peedrooh/seebum_sobrado_pcb/line_sensor/datasheets/6-1.png

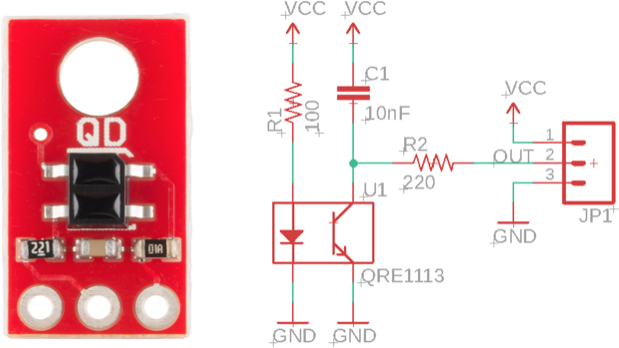
line_sensor/datasheets/6-1.png
