peedrooh/seebum_sobrado_pcb/seebum_esp32s3/Resources/Aliexpress ESP32S3.png

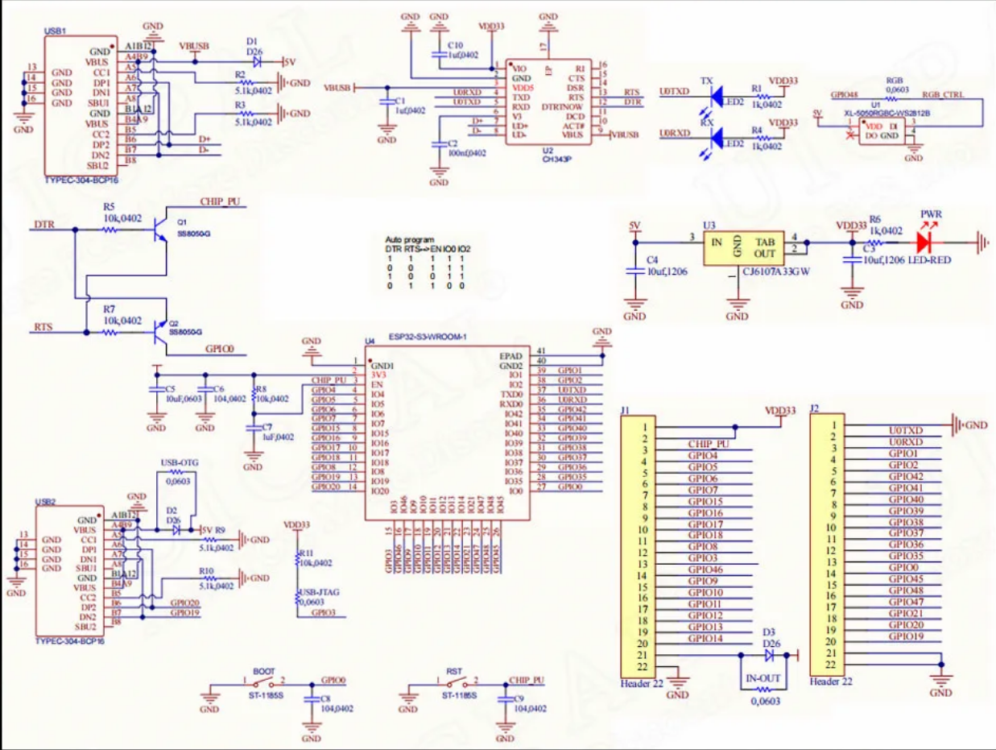
seebum_esp32s3/Resources/Aliexpress ESP32S3.png
