peedrooh/seebum_sobrado_pcb/seebum_esp32s3/Resources/Buck Schematic.png

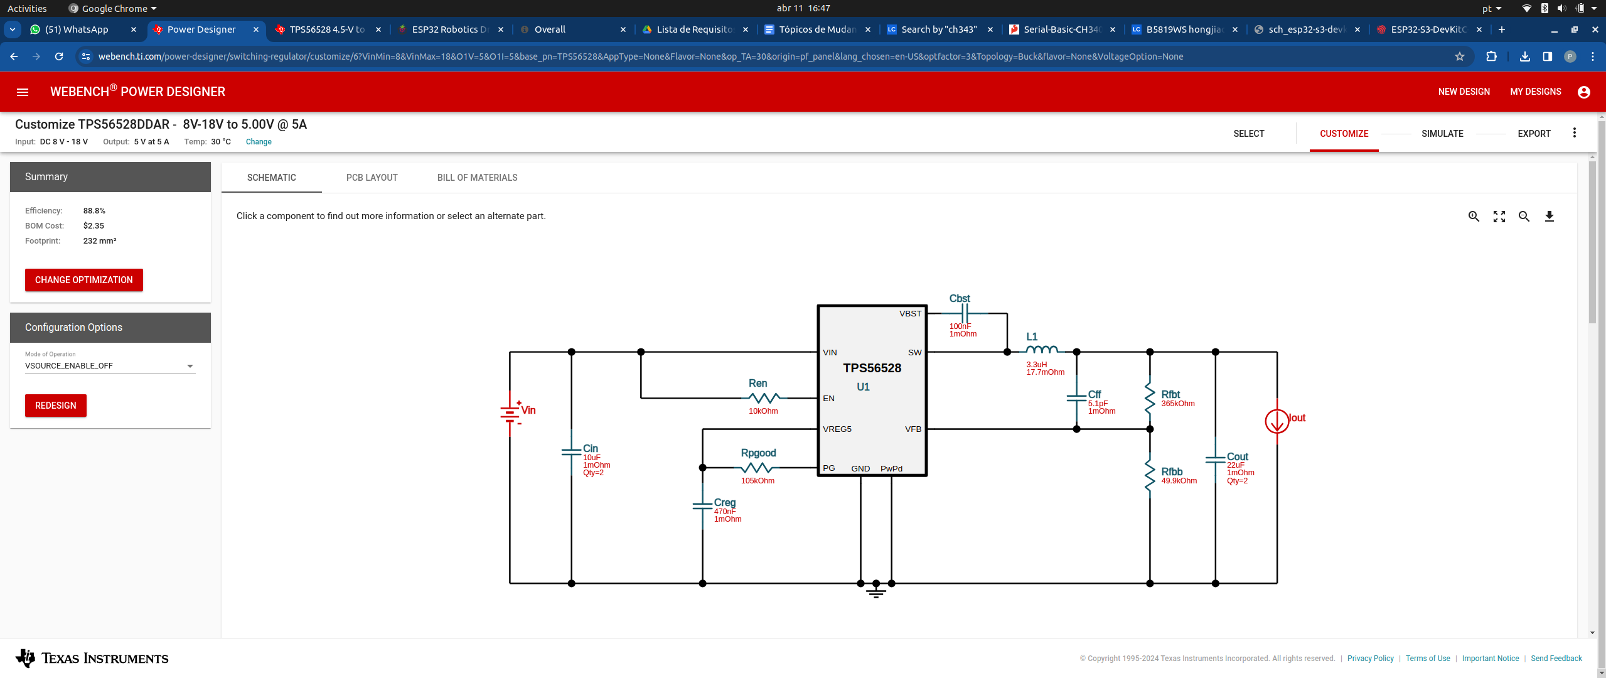
seebum_esp32s3/Resources/Buck Schematic.png
