peedrooh/seebum_sobrado_pcb/seebum_esp32s3/3D Models/User Library-XT30.STEP

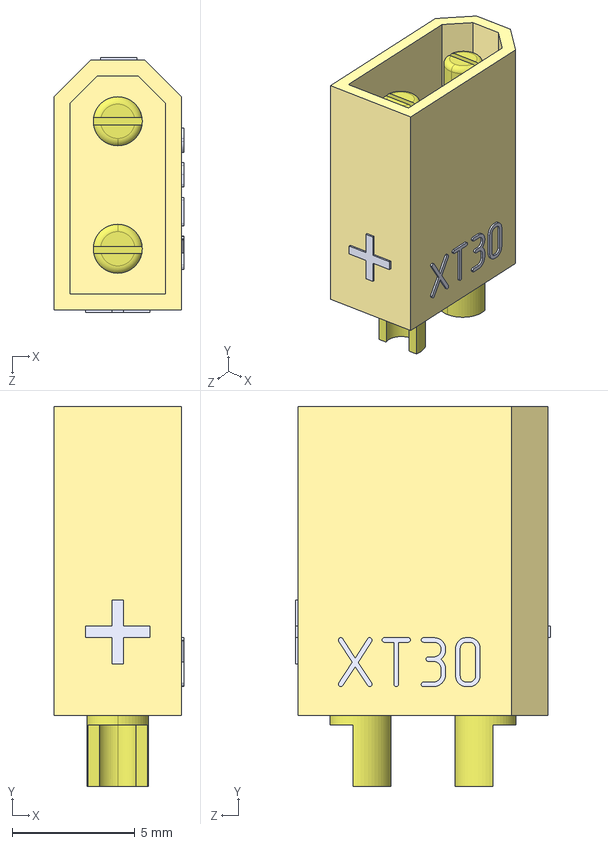
[picture p5: CAD file, 2024-04-22]
seebum_esp32s3/3D Models/User Library-XT30.STEP
5.30 x 15.5 x 10.4 mm
