peedrooh/seebum_sobrado_pcb/seebum_esp32s3/3D Models/xt30-male-2.snapshot.1/XT30-male.stp

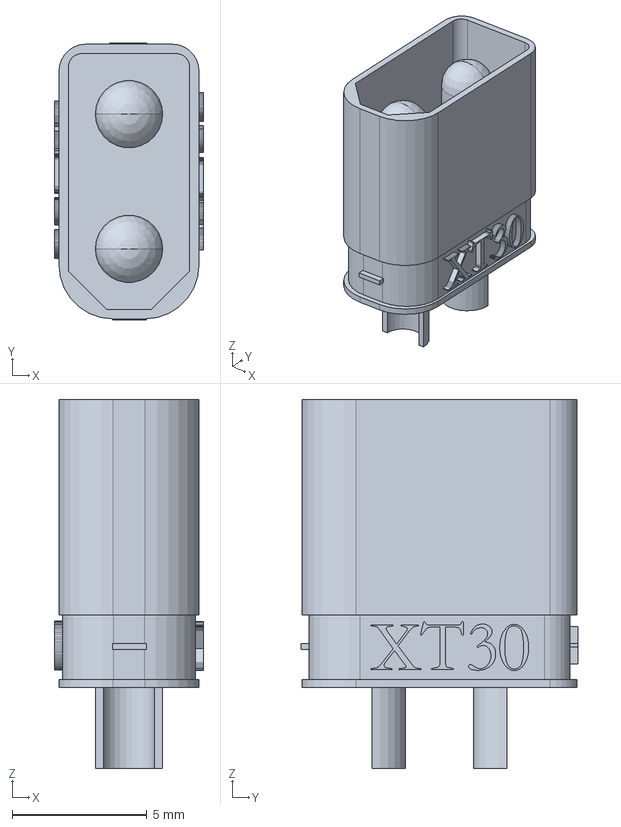
[picture p6: CAD file, 2024-04-22]
seebum_esp32s3/3D Models/xt30-male-2.snapshot.1/XT30-male.stp
5.54 x 10.3 x 13.7 mm
