peedrooh/seebum_sobrado_pcb/Solidworks 3D Models/seebum_peripherals.step

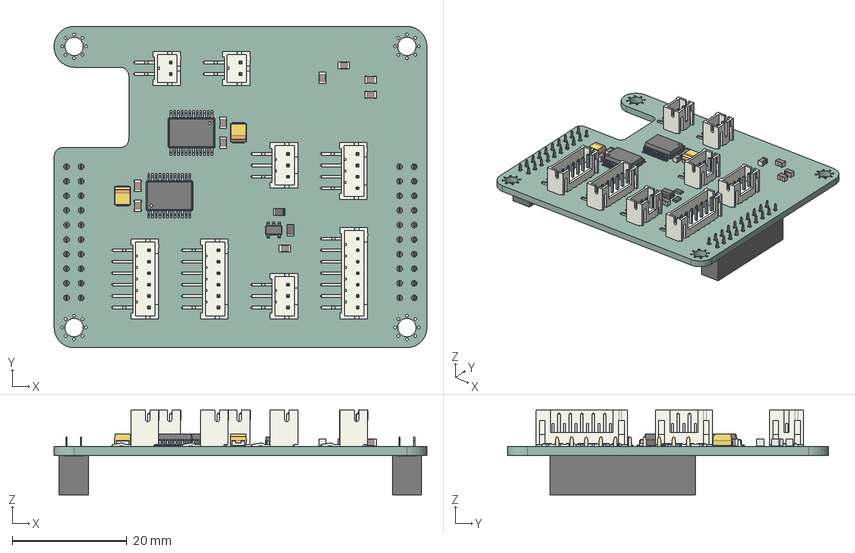
[picture p7: CAD file, 2024-04-23]
Solidworks 3D Models/seebum_peripherals.step
65.0 x 56.0 x 14.8 mm
JST_S4B_PH_K
C_0805_2012Metric x 9
CP_EIA_3528_21_Kemet_B x 2
PinSocket_2x10_P254mm_Vertical x 2
SOT_23_5
JST_S2B_PH_K x 2
JST_S3B_PH_K x 2
SSOP_24_53x82mm_P065mm x 2
JST_S6B_PH_K x 2
R_0805_2012Metric x 2
JST_S7B_PH_K
seebum_peripherals_PCB
