peedrooh/seebum_sobrado_pcb/seebum_esp32s3/3D Models/5Amp_Switch.stp

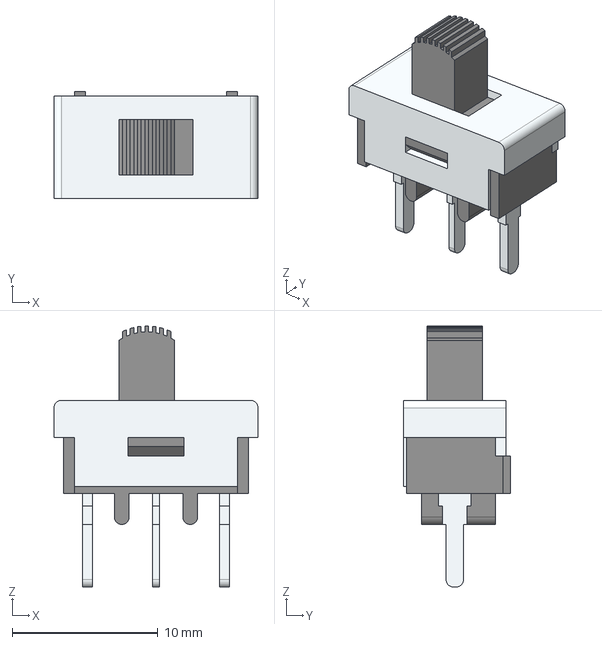
[picture p8: CAD file, 2024-04-22]
seebum_esp32s3/3D Models/5Amp_Switch.stp
14.0 x 7.32 x 17.9 mm
