peedrooh/seebum_sobrado_pcb/seebum_esp32s3/3D Models/Connectors_Amass.3dshapes-master/Amass_MR30PB-FB.step

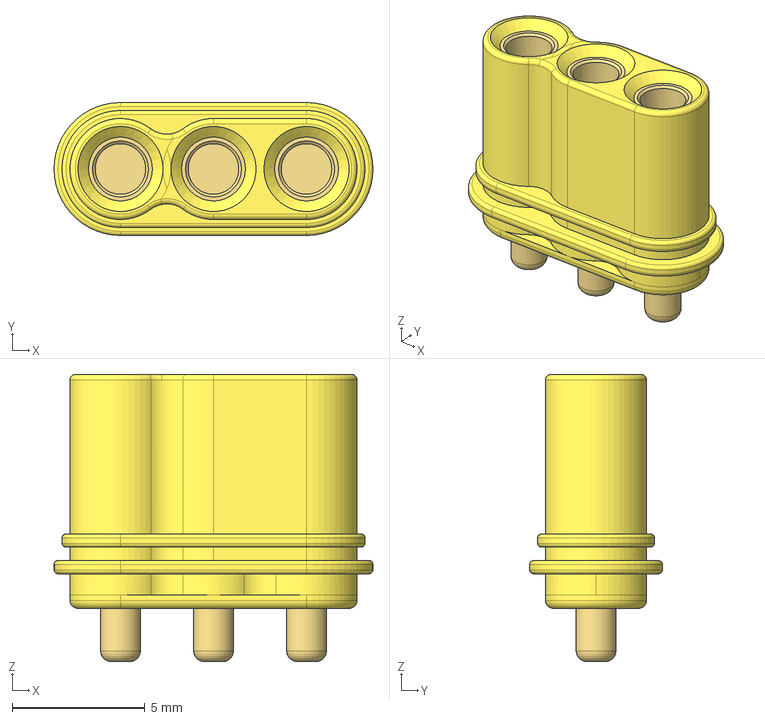
[picture p9: CAD file, 2024-04-22]
seebum_esp32s3/3D Models/Connectors_Amass.3dshapes-master/Amass_MR30PB-FB.step
12.0 x 5.00 x 10.8 mm
