peedrooh/seebum_sobrado_pcb/Solidworks 3D Models/line_sensor.step

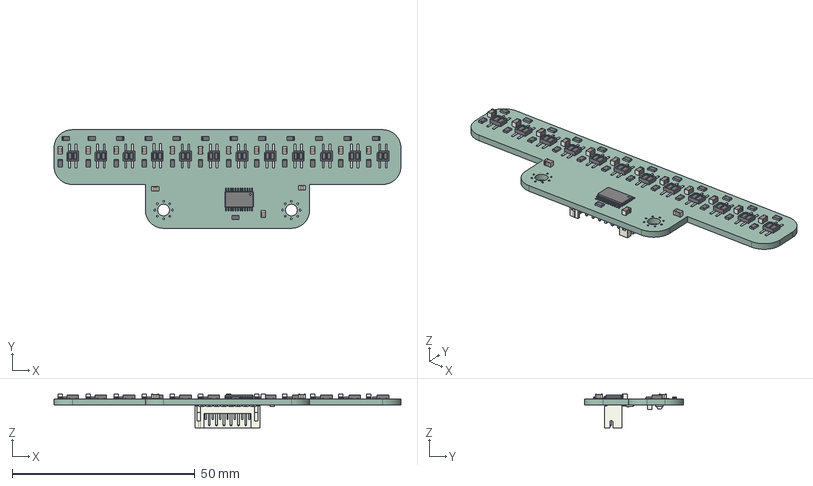
[picture p10: CAD file, 2024-04-23]
Solidworks 3D Models/line_sensor.step
95.0 x 27.0 x 9.20 mm
R_0805_2012Metric x 27
C_0805_2012Metric x 16
Everlight_ITR8307 x 12
TSSOP_24_44x78mm_P065mm
LED_0805_2012Metric
JST_S8B_PH_K
line_sensor_PCB
