peedrooh/seebum_sobrado_pcb/seebum_esp32s3/3D Models/Connectors_Amass.3dshapes-master/Amass_XT30UPB-M.step

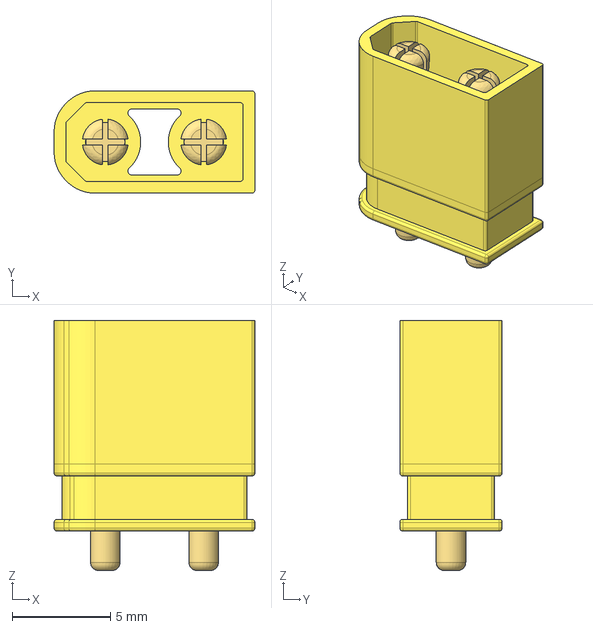
[picture p12: CAD file, 2024-04-22]
seebum_esp32s3/3D Models/Connectors_Amass.3dshapes-master/Amass_XT30UPB-M.step
10.2 x 5.20 x 12.7 mm
