peedrooh/seebum_sobrado_pcb/(list of files, cad)

Other CAD files:
Solidworks 3D Models/line_sensor.SLDASM
Solidworks 3D Models/seebum_peripherals.SLDASM
seebum_esp32s3/3D Models/xt30-male-2.snapshot.1/XT30-male.CATPart
