peedrooh/seebum_sobrado_pcb/line_sensor/line_sensor.kicad_pcb

## KiCad design line_sensor/line_sensor.kicad_pcb (2024-05-30)

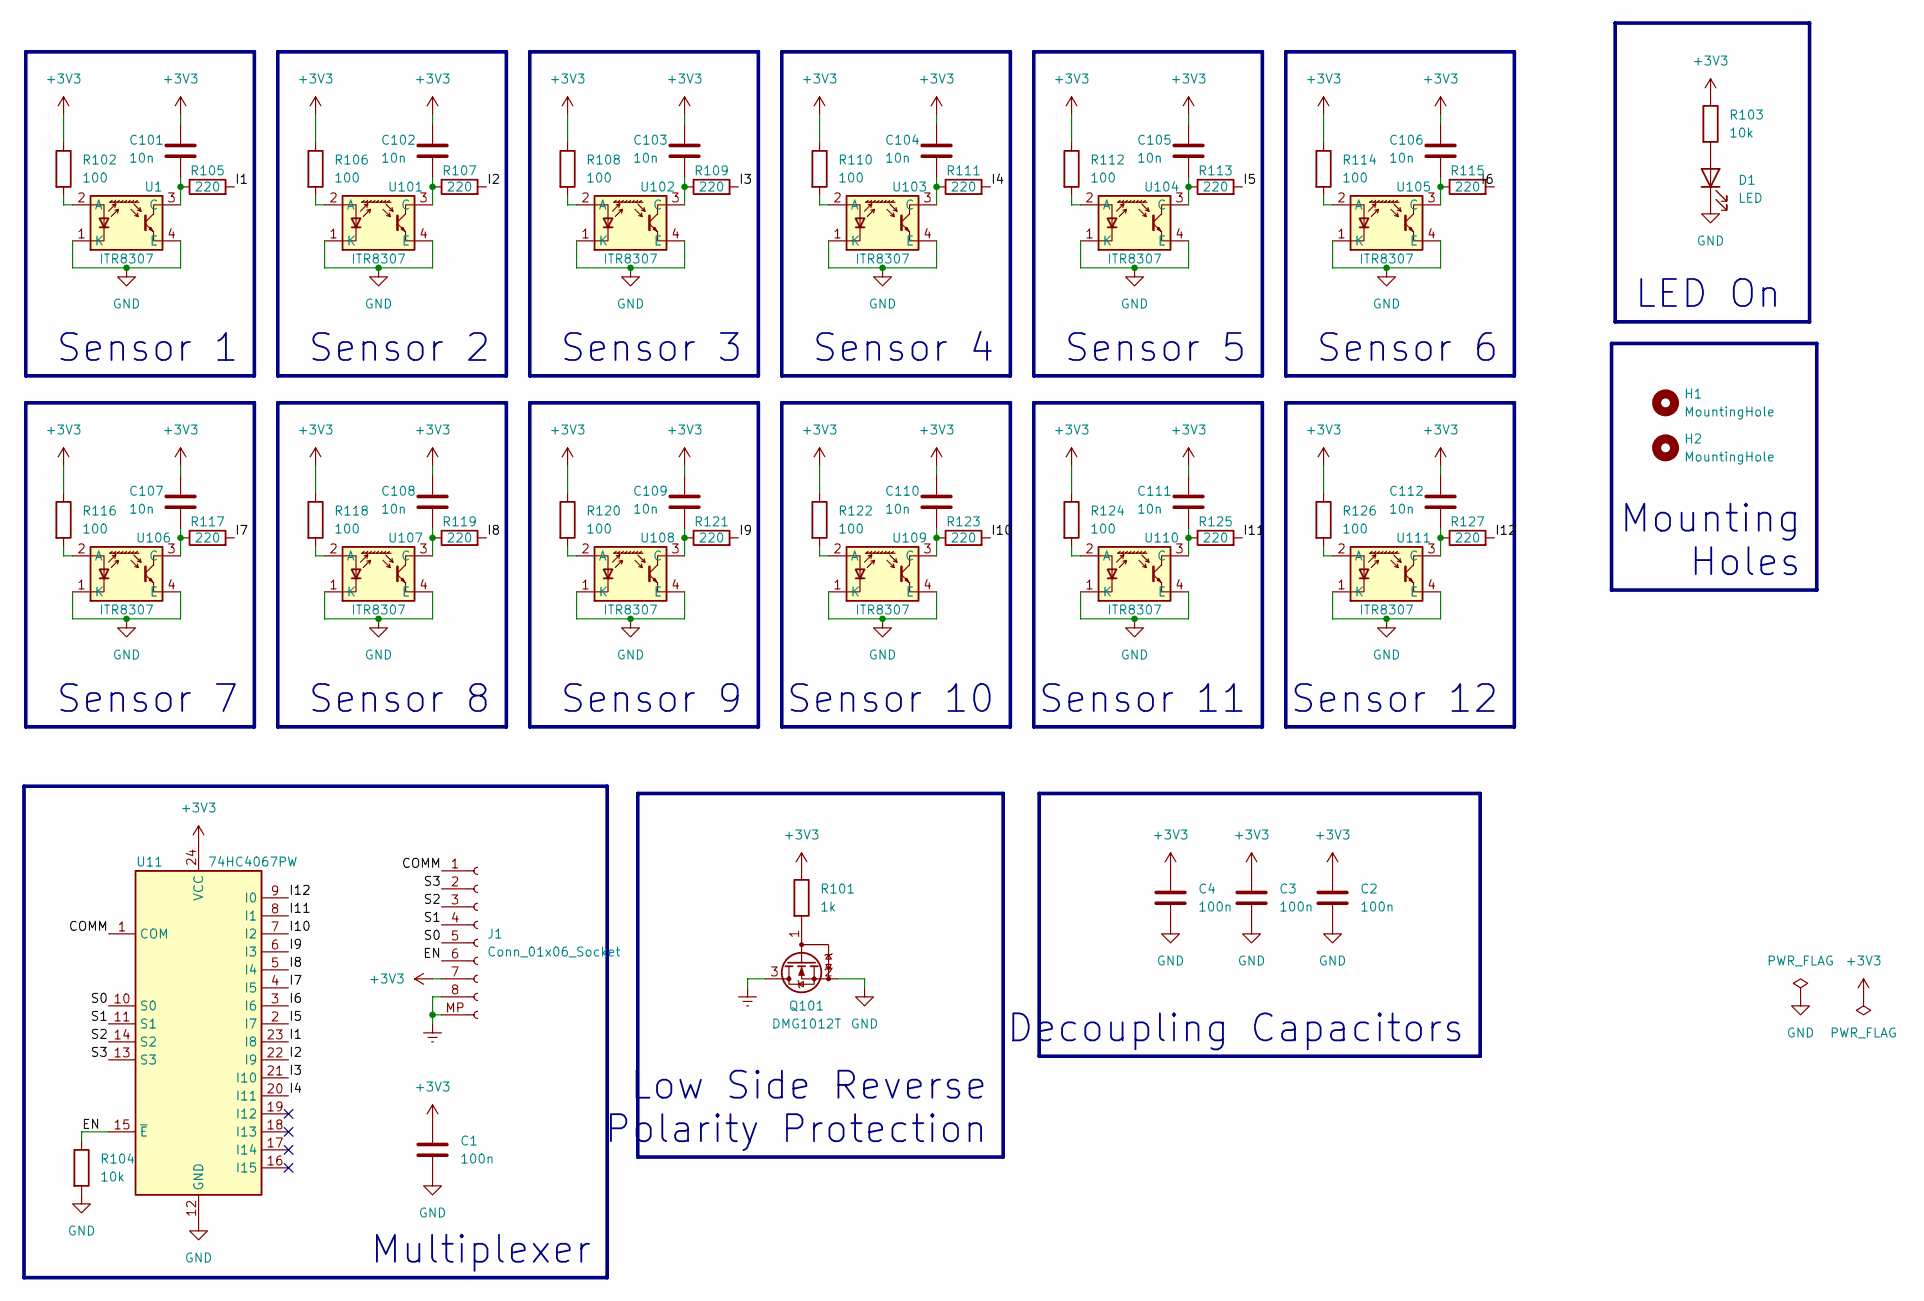
[picture p13: schematic line_sensor.kicad_sch, Line Sensor]

Parts:
C1, C2, C3, C4: 100n; C_0805_2012Metric_Pad1.18x1.45mm_HandSolder; LCSC C38141
C101, C102, C103, C104, C105, C106, C107, C108, C109, C110, C111, C112: 10n; C_0805_2012Metric_Pad1.18x1.45mm_HandSolder
D1: LED; LED_0805_2012Metric; LCSC C391863
H1, H2: MountingHole; MountingHole_3.2mm_M3_Pad_Via
J1: Conn_01x06_Socket; JST_PH_B8B-PH-SM4-TB_1x08-1MP_P2.00mm_Vertical
Q101: DMG1012T; SOT-523; LCSC C20512
R101: 1k; R_0805_2012Metric; LCSC C17513
R102, R106, R108, R110, R112, R114, R116, R118, R120, R122, R124, R126: 100; R_0805_2012Metric
R103, R104: 10k; R_0805_2012Metric
R105, R107, R109, R111, R113, R115, R117, R119, R121, R123, R125, R127: 220; R_0805_2012Metric
U1, U101, U102, U103, U104, U105, U106, U107, U108, U109, U110, U111: ITR8307; ITR8307_S18_TR8_B; LCSC C115037
U11: 74HC4067PW; TSSOP-24_4.4x7.8mm_P0.65mm; LCSC C179326

Connections:
+3V3: C1.1, C2.1, C3.1, C4.1, C101.1, C102.1, C103.1, C104.1, C105.1, C106.1, C107.1, C108.1, C109.1, C110.1, C111.1, C112.1, J1.7, R101.1, R102.1, R103.1, R106.1, R108.1, R110.1, R112.1, R114.1, R116.1, R118.1, R120.1, R122.1, R124.1, R126.1, U11.24 (VCC)
/COMM: J1.1, U11.1 (COM)
/EN: J1.6, R104.1, U11.15 (~E)
/I1: R105.2, U11.23 (I8)
/I2: R107.2, U11.22 (I9)
/I3: R109.2, U11.21 (I10)
/I4: R111.2, U11.20 (I11)
/I5: R113.2, U11.2 (I7)
/I6: R115.2, U11.3 (I6)
/I7: R117.2, U11.4 (I5)
/I8: R119.2, U11.5 (I4)
/I9: R121.2, U11.6 (I3)
/I10: R123.2, U11.7 (I2)
/I11: R125.2, U11.8 (I1)
/I12: R127.2, U11.9 (I0)
/S0: J1.5, U11.10 (S0)
/S1: J1.4, U11.11 (S1)
/S2: J1.3, U11.14 (S2)
/S3: J1.2, U11.13 (S3)
Earth: J1.8, J1.MP (Pin_9), Q101.3 (D)
GND: C1.2, C2.2, C3.2, C4.2, D1.1 (K), Q101.2 (S), R104.2, U1.1 (K), U1.4 (E), U11.12 (GND), U101.1 (K), U101.4 (E), U102.1 (K), U102.4 (E), U103.1 (K), U103.4 (E), U104.1 (K), U104.4 (E), U105.1 (K), U105.4 (E), U106.1 (K), U106.4 (E), U107.1 (K), U107.4 (E), U108.1 (K), U108.4 (E), U109.1 (K), U109.4 (E), U110.1 (K), U110.4 (E), U111.1 (K), U111.4 (E)
unnamed: D1.2 (A), R103.2
unnamed: Q101.1 (G), R101.2
unnamed: R102.2, U1.2 (A)
unnamed: C101.2, R105.1, U1.3 (C)
unnamed: R106.2, U101.2 (A)
unnamed: C102.2, R107.1, U101.3 (C)
unnamed: R108.2, U102.2 (A)
unnamed: C103.2, R109.1, U102.3 (C)
unnamed: R110.2, U103.2 (A)
unnamed: C104.2, R111.1, U103.3 (C)
unnamed: R112.2, U104.2 (A)
unnamed: C105.2, R113.1, U104.3 (C)
unnamed: R114.2, U105.2 (A)
unnamed: C106.2, R115.1, U105.3 (C)
unnamed: R116.2, U106.2 (A)
unnamed: C107.2, R117.1, U106.3 (C)
unnamed: R118.2, U107.2 (A)
unnamed: C108.2, R119.1, U107.3 (C)
unnamed: R120.2, U108.2 (A)
unnamed: C109.2, R121.1, U108.3 (C)
unnamed: R122.2, U109.2 (A)
unnamed: C110.2, R123.1, U109.3 (C)
unnamed: R124.2, U110.2 (A)
unnamed: C111.2, R125.1, U110.3 (C)
unnamed: R126.2, U111.2 (A)
unnamed: C112.2, R127.1, U111.3 (C)

Notes on the sheet:
Low Side Reverse Polarity Protection
Sensor 4
Sensor 3
Sensor 12
Sensor 2
Sensor 8
Sensor 1
Sensor 10
Sensor 5
LED On
Sensor 9
Sensor 11
Sensor 6
Mounting Holes
Decoupling Capacitors
Multiplexer
Sensor 7

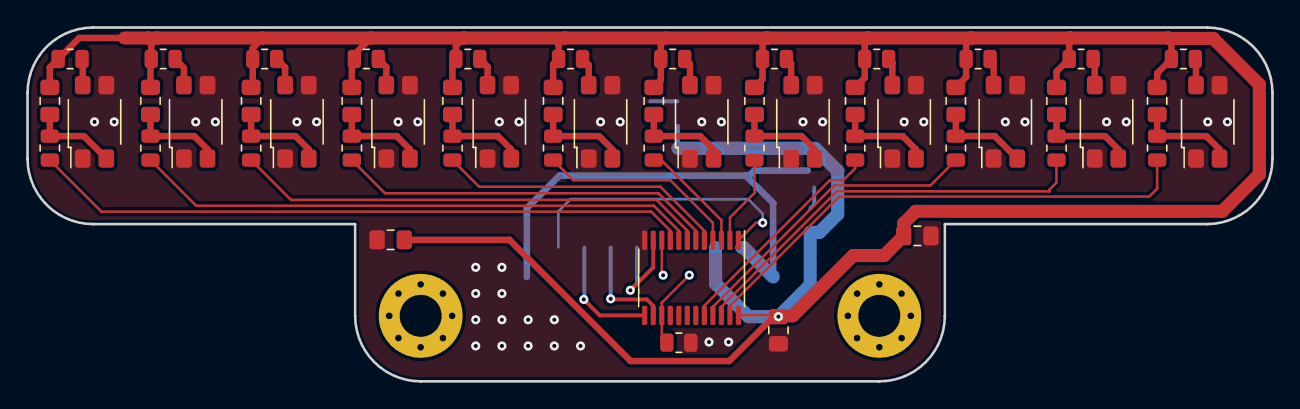
[picture p14: board line_sensor.kicad_pcb from above]

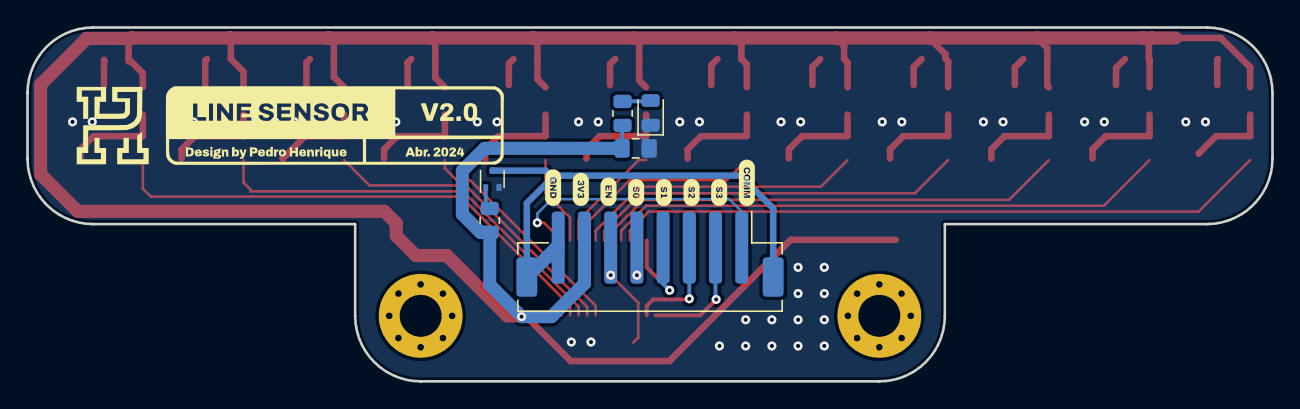
[picture p15: board line_sensor.kicad_pcb from below]

Board: 2 copper layers, 95.0 x 27.0 mm, 61 parts (6 on the bottom side), 47 nets.
