peedrooh/seebum_sobrado_pcb/seebum_peripherals/seebum_peripherals.kicad_pcb

## KiCad design seebum_peripherals/seebum_peripherals.kicad_pcb (2024-05-30)

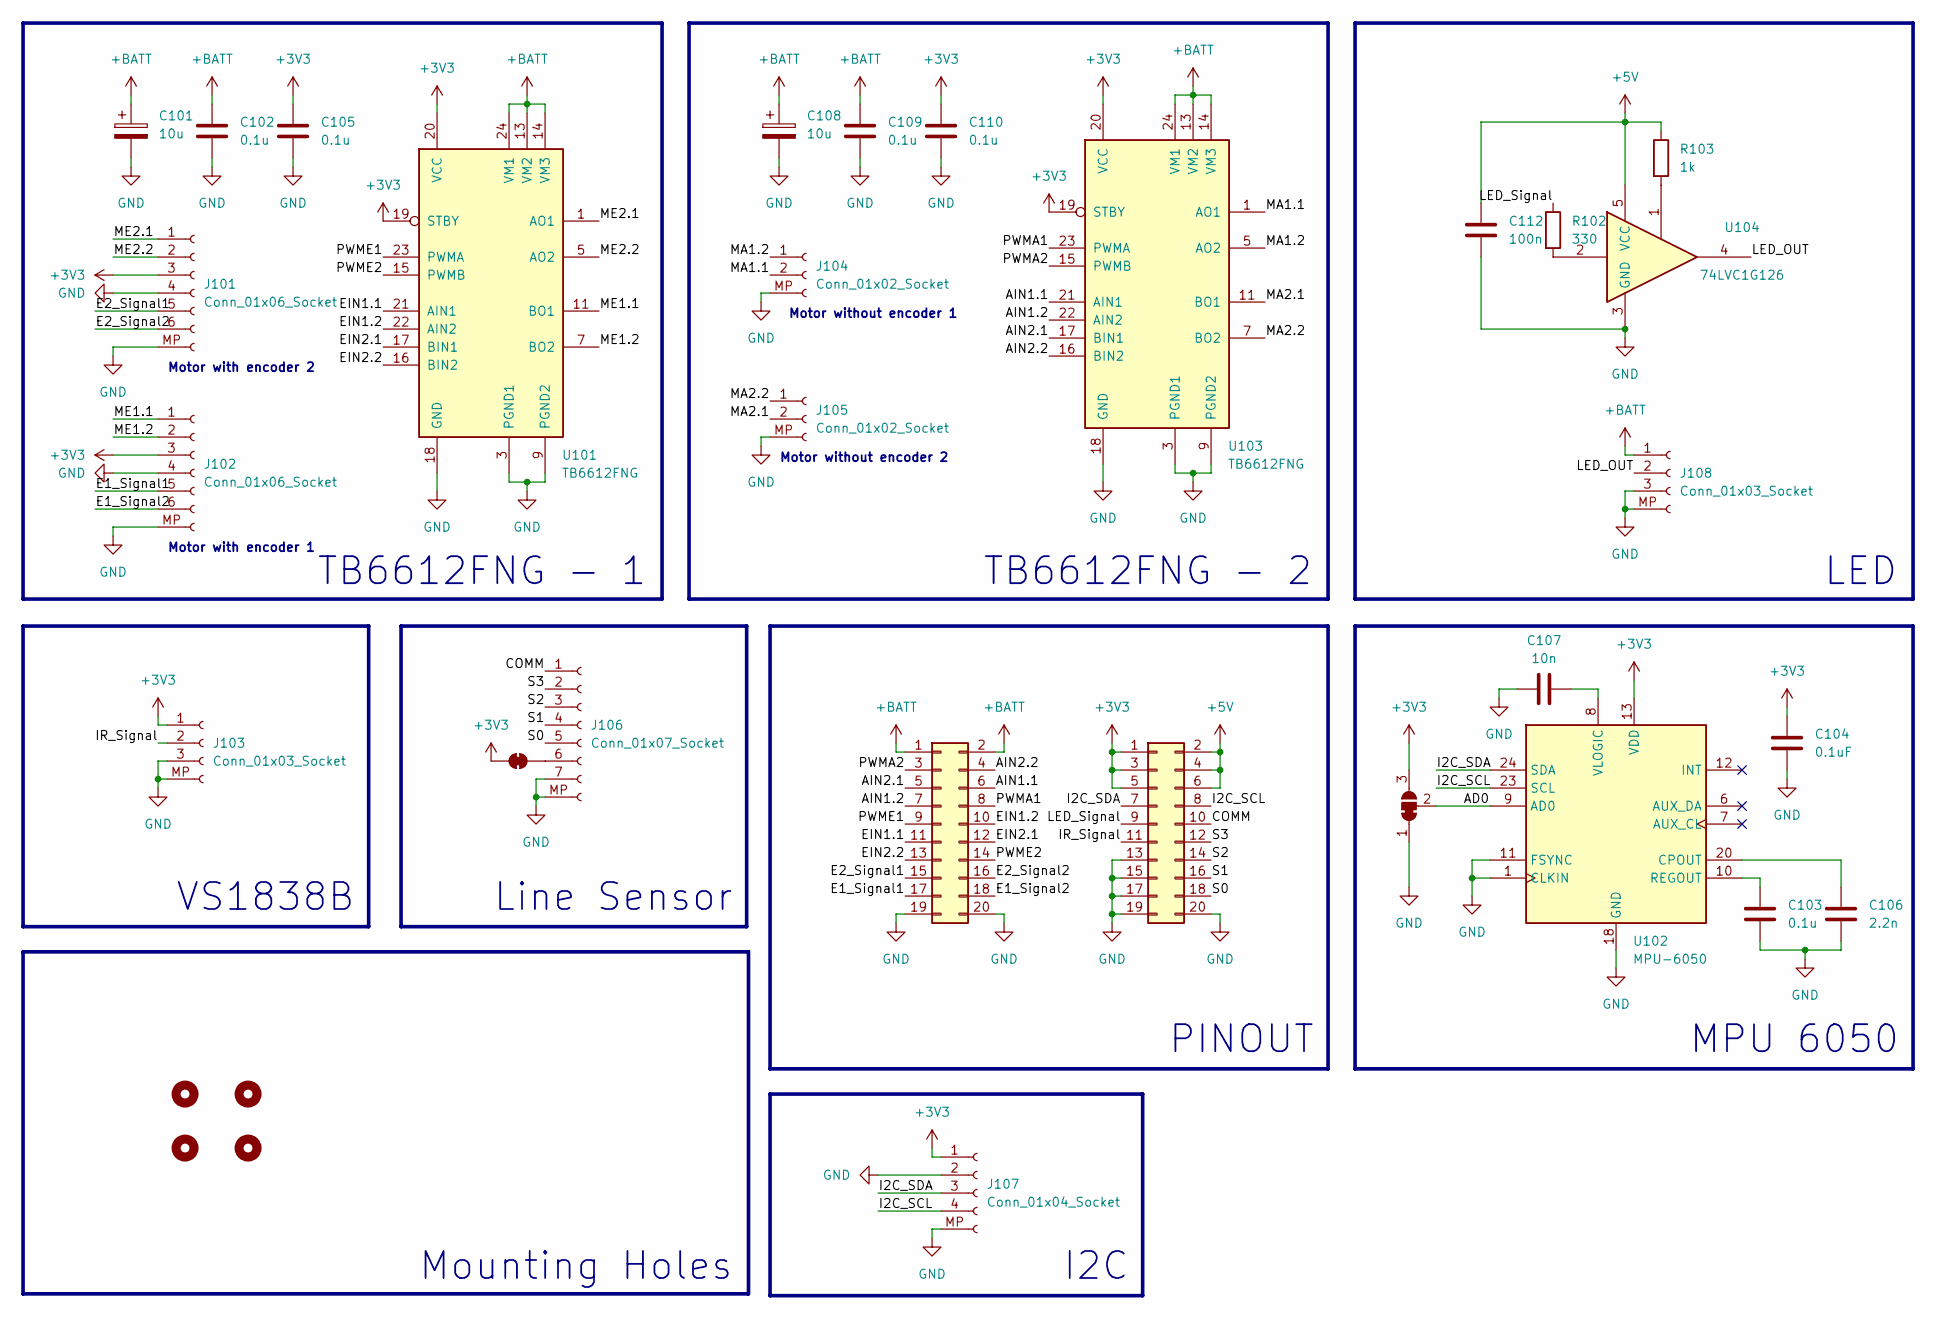
[picture p16: schematic seebum_peripherals.kicad_sch]

Parts:
C101, C108: 10u; CP_EIA-3528-21_Kemet-B; LCSC C163225
C102, C103, C105, C109, C110: 0.1u; C_0805_2012Metric; LCSC C38141
C104: 0.1uF; C_0805_2012Metric; LCSC C38141
C106: 2.2n; C_0805_2012Metric; LCSC C36576
C107: 10n; C_0805_2012Metric; LCSC C36576
C112: 100n; C_0805_2012Metric; LCSC C38141
H101, H102, H103, H104: MountingHole; M2.5M3
J101, J102: Conn_01x06_Socket; JST_PH_B6B-PH-SM4-TB_1x06-1MP_P2.00mm_Vertical; LCSC C265088
J103, J108: Conn_01x03_Socket; JST_PH_B3B-PH-SM4-TB_1x03-1MP_P2.00mm_Vertical; LCSC C160353
J104, J105: Conn_01x02_Socket; JST_PH_B2B-PH-SM4-TB_1x02-1MP_P2.00mm_Vertical; LCSC C160352
J106: Conn_01x07_Socket; JST_PH_B7B-PH-SM4-TB_1x07-1MP_P2.00mm_Vertical; LCSC C495700
J107: Conn_01x04_Socket; JST_PH_B4B-PH-SM4-TB_1x04-1MP_P2.00mm_Vertical
J109, J110: Conn_02x10_Odd_Even; PinSocket_2x10_P2.54mm_Vertical
JP101: SolderJumper_3_Bridged12; SolderJumper-3_P1.3mm_Bridged12_RoundedPad1.0x1.5mm
JP102: SolderJumper_2_Bridged; SolderJumper-2_P1.3mm_Bridged_RoundedPad1.0x1.5mm
R102: 330; R_0805_2012Metric; LCSC C17630
R103: 1k; R_0805_2012Metric; LCSC C17513
U101, U103: TB6612FNG; SSOP-24_5.3x8.2mm_P0.65mm; LCSC C88224
U102: MPU-6050; InvenSense_QFN-24_4x4mm_P0.5mm; LCSC C24112
U104: 74LVC1G126; SOT-23-5; LCSC C7834

Connections:
+3V3: C104.1, C105.1, C110.1, J101.3, J102.3, J103.1, J107.1, J110.1, J110.3, J110.5, JP101.3 (B), JP102.1 (A), U101.19 (STBY), U101.20 (VCC), U102.13 (VDD), U103.19 (STBY), U103.20 (VCC)
+5V: C112.1, J110.2, J110.4, J110.6, R103.1, U104.5 (VCC)
+BATT: C101.1, C102.1, C108.1, C109.1, J108.1, J109.1, J109.2, U101.13 (VM2), U101.14 (VM3), U101.24 (VM1), U103.13 (VM2), U103.14 (VM3), U103.24 (VM1)
/AD0: JP101.2 (C), U102.9 (AD0)
/AIN1.1: J109.6, U103.21 (AIN1)
/AIN1.2: J109.7, U103.22 (AIN2)
/AIN2.1: J109.5, U103.17 (BIN1)
/AIN2.2: J109.4, U103.16 (BIN2)
/COMM: J106.1, J110.10
/E1_Signal1: J102.5, J109.17
/E1_Signal2: J102.6, J109.18
/E2_Signal1: J101.5, J109.15
/E2_Signal2: J101.6, J109.16
/EIN1.1: J109.11, U101.21 (AIN1)
/EIN1.2: J109.10, U101.22 (AIN2)
/EIN2.1: J109.12, U101.17 (BIN1)
/EIN2.2: J109.13, U101.16 (BIN2)
/I2C_SCL: J107.4, J110.8, U102.23 (SCL)
/I2C_SDA: J107.3, J110.7, U102.24 (SDA)
/IR_Signal: J103.2, J110.11
/LED_OUT: J108.2, U104.4
/LED_Signal: J110.9, R102.1
/MA1.1: J104.2, U103.1 (AO1), U103.2 (AO1)
/MA1.2: J104.1, U103.5 (AO2), U103.6 (AO2)
/MA2.1: J105.2, U103.11 (BO1), U103.12 (BO1)
/MA2.2: J105.1, U103.7 (BO2), U103.8 (BO2)
/ME1.1: J102.1, U101.11 (BO1), U101.12 (BO1)
/ME1.2: J102.2, U101.7 (BO2), U101.8 (BO2)
/ME2.1: J101.1, U101.1 (AO1), U101.2 (AO1)
/ME2.2: J101.2, U101.5 (AO2), U101.6 (AO2)
/PWMA1: J109.8, U103.23 (PWMA)
/PWMA2: J109.3, U103.15 (PWMB)
/PWME1: J109.9, U101.23 (PWMA)
/PWME2: J109.14, U101.15 (PWMB)
/S0: J106.5, J110.18
/S1: J106.4, J110.16
/S2: J106.3, J110.14
/S3: J106.2, J110.12
GND: C101.2, C102.2, C103.2, C104.2, C105.2, C106.2, C107.1, C108.2, C109.2, C110.2, C112.2, J101.4, J101.MP (Pin_7), J102.4, J102.MP (Pin_7), J103.3, J103.MP (Pin_4), J104.MP (Pin_3), J105.MP (Pin_3), J106.7, J106.MP (Pin_8), J107.2, J107.MP (Pin_5), J108.3, J108.MP (Pin_4), J109.19, J109.20, J110.13, J110.15, J110.17, J110.19, J110.20, JP101.1 (A), U101.3 (PGND1), U101.4 (PGND1), U101.9 (PGND2), U101.10 (PGND2), U101.18 (GND), U102.1 (CLKIN), U102.11 (FSYNC), U102.18 (GND), U103.3 (PGND1), U103.4 (PGND1), U103.9 (PGND2), U103.10 (PGND2), U103.18 (GND), U104.3 (GND)
unnamed: J106.6, JP102.2 (B)
unnamed: R102.2, U104.2
unnamed: R103.2, U104.1
unnamed: C106.1, U102.20 (CPOUT)
unnamed: C103.1, U102.10 (REGOUT)
unnamed: C107.2, U102.8 (VLOGIC)

Notes on the sheet:
TB6612FNG - 1
VS1838B
Motor with encoder 2
Motor with encoder 1
Mounting Holes
Motor without encoder 2
Motor without encoder 1
LED
Line Sensor
TB6612FNG - 2
MPU 6050
PINOUT
I2C

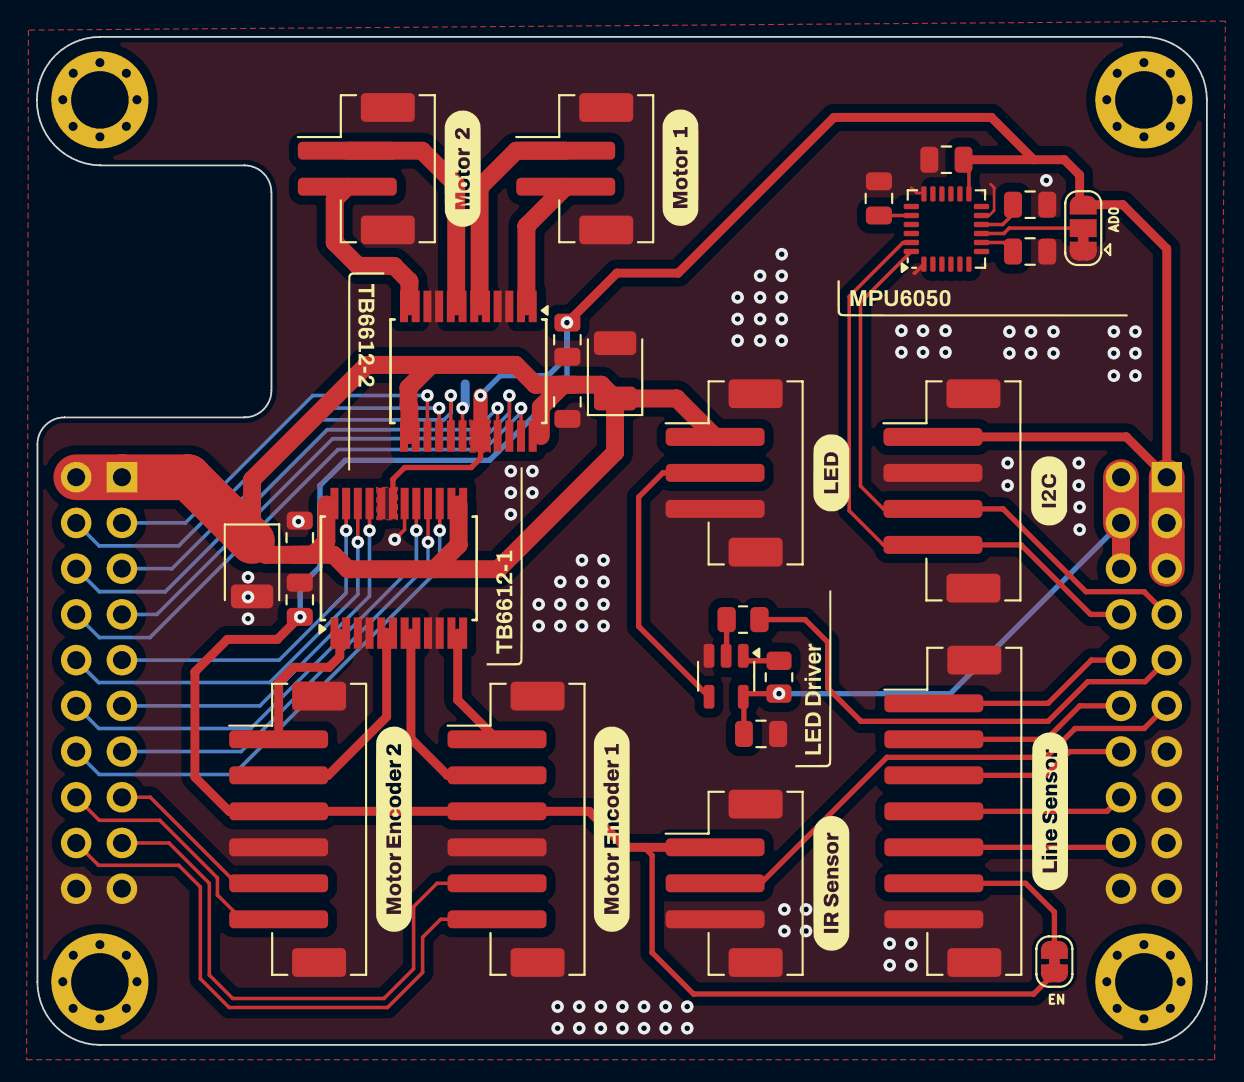
[picture p17: board seebum_peripherals.kicad_pcb from above]

Board: 2 copper layers, 65.0 x 56.0 mm, 33 parts (0 on the bottom side), 45 nets.
