peedrooh/seebum_sobrado_pcb/seebum_esp32s3/seebum_esp32s3.kicad_pcb

## KiCad design seebum_esp32s3/seebum_esp32s3.kicad_pcb (2024-05-30)

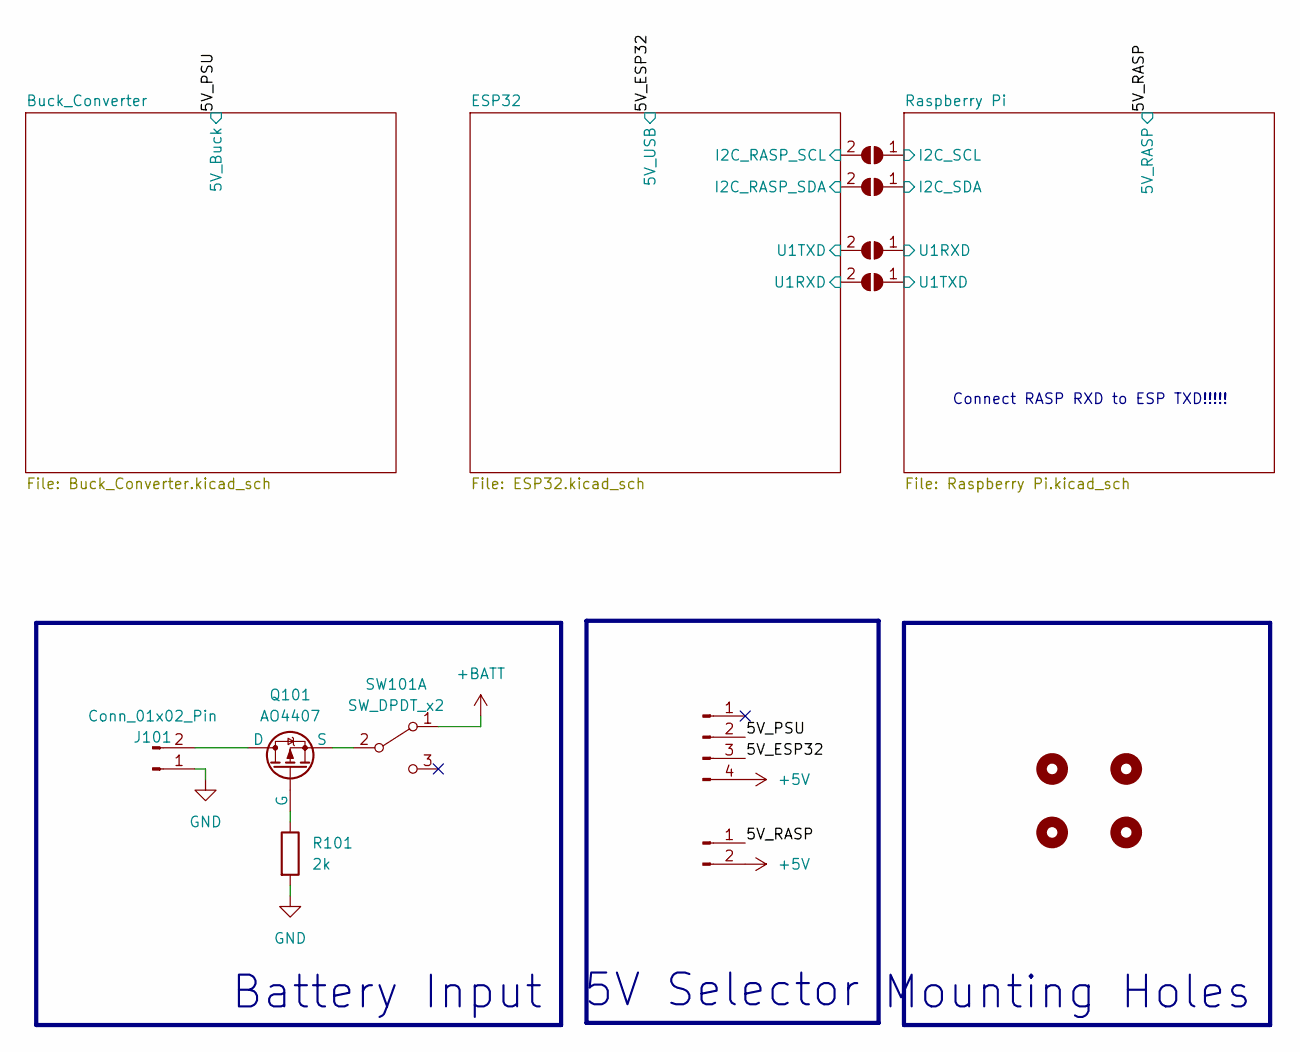
[picture p18: schematic seebum_esp32s3.kicad_sch]

Parts:
H101, H102, H103, H104: MountingHole; M2.5M3
J101: Conn_01x02_Pin; AMASS_XT30UPB-M_1x02_P5.0mm_Vertical
J102: Conn_01x04_Pin; PinHeader_2x02_P2.54mm_Vertical
J103: Conn_01x02_Pin; PinHeader_1x02_P2.54mm_Vertical
JP101, JP102: SolderJumper_2_Open; SolderJumper-2_P1.3mm_Open_TrianglePad1.0x1.5mm
JP103, JP104: SolderJumper_2_Open; SolderJumper-2_P1.3mm_Bridged_RoundedPad1.0x1.5mm
Q101: AO4407; SO-8_5.3x6.2mm_P1.27mm; LCSC C469397
R101: 2k; R_0805_2012Metric; LCSC C17604
SW101: SW_DPDT_x2; 5Amp_Switch; LCSC C2884744

Connections:
+5V: J102.4, J103.2; also elsewhere on the board
+BATT: SW101.1 (A); also elsewhere on the board
/5V_ESP32: J102.3; also elsewhere on the board
/5V_PSU: J102.2; also elsewhere on the board
/5V_RASP: J103.1; also elsewhere on the board
/ESP32/GPIO17: JP102.2 (B), JP103.2 (B); also elsewhere on the board
/ESP32/GPIO18: JP101.2 (B), JP104.2 (B); also elsewhere on the board
/Raspberry Pi/RASP_RX: JP103.1 (A); also elsewhere on the board
/Raspberry Pi/RASP_SCL: JP101.1 (A); also elsewhere on the board
/Raspberry Pi/RASP_SDA: JP102.1 (A); also elsewhere on the board
/Raspberry Pi/RASP_TX: JP104.1 (A); also elsewhere on the board
GND: J101.1, R101.2; also elsewhere on the board
unnamed: J101.2, Q101.1 (D)
unnamed: Q101.2 (G), R101.1
unnamed: Q101.3 (S), SW101.2 (B)

Notes on the sheet:
5V Selector
Battery Input
Mounting Holes
Connect RASP RXD to ESP TXD!!!!!

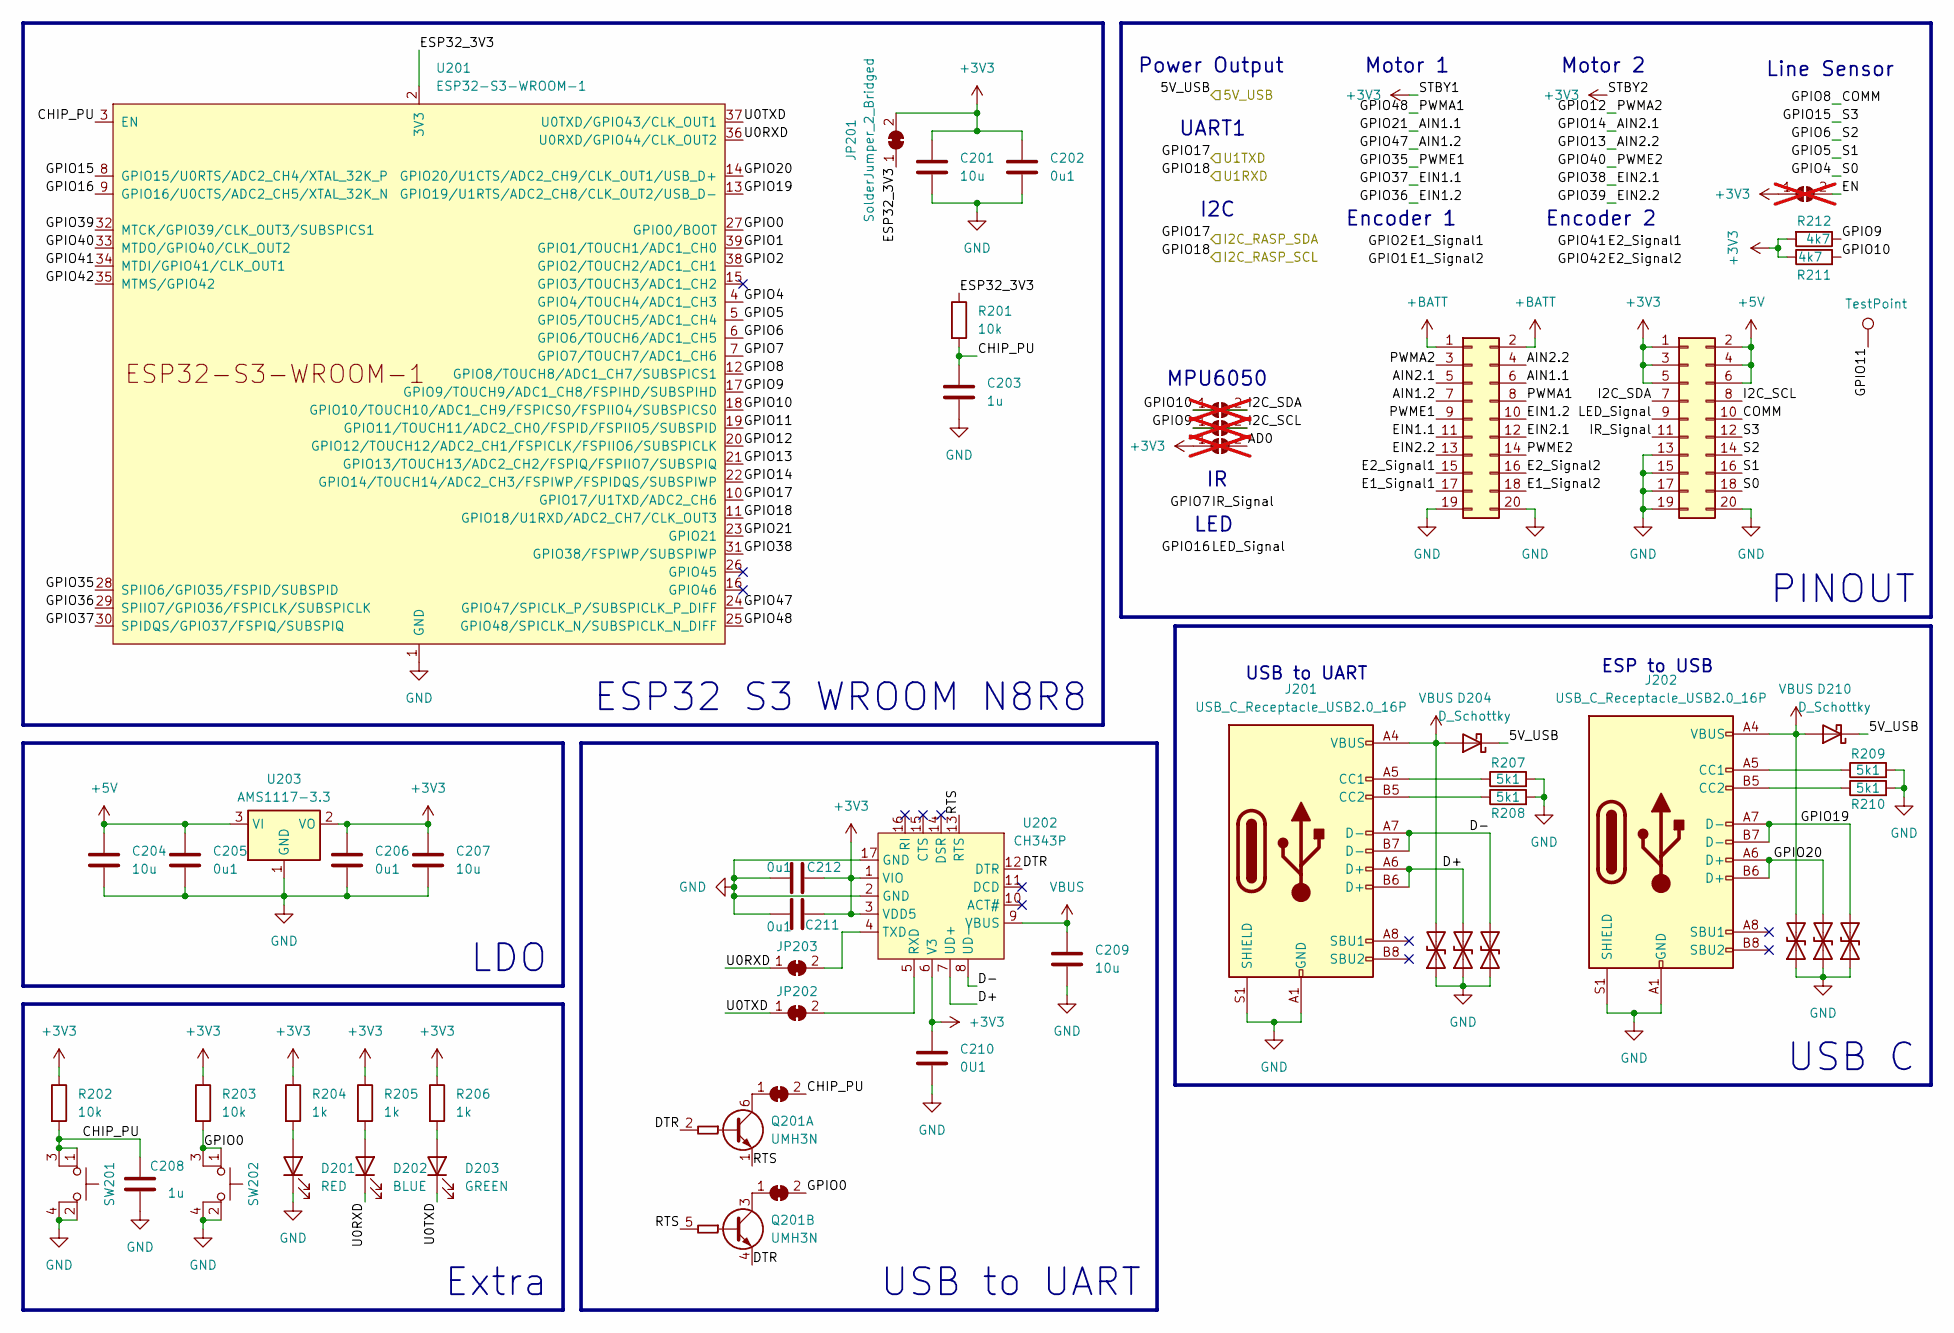
[picture p19: schematic ESP32.kicad_sch]

Parts:
C201, C204, C207, C209: 10u; C_0805_2012Metric_Pad1.18x1.45mm_HandSolder
C202, C205, C206, C211, C212: 0u1; C_0805_2012Metric_Pad1.18x1.45mm_HandSolder
C203, C208: 1u; C_0805_2012Metric_Pad1.18x1.45mm_HandSolder
C210: 0U1; C_0805_2012Metric_Pad1.18x1.45mm_HandSolder
D201: RED; LED_0805_2012Metric
D202: BLUE; LED_0805_2012Metric; LCSC C205441
D203: GREEN; LED_0805_2012Metric; LCSC C84260
D204, D210: D_Schottky; D_SOD-323; LCSC C2891705
D205, D206, D207, D208, D209, D211: D_TVS; D_SOD-523; LCSC C383211
J201, J202: USB_C_Receptacle_USB2.0_16P; USB_C_Receptacle_G-Switch_GT-USB-7010ASV; LCSC C2765186
J203, J204: Conn_02x10_Odd_Even; PinHeader_2x10_P2.54mm_Vertical
JP201, JP202, JP203, JP206, JP207: SolderJumper_2_Bridged; SolderJumper-2_P1.3mm_Bridged_RoundedPad1.0x1.5mm
JP204, JP205, JP208, JP209: SolderJumper_2_Open; SolderJumper-2_P1.3mm_Open_TrianglePad1.0x1.5mm; not fitted
Q201: UMH3N; SOT-363_SC-70-6; LCSC C62892
R201, R202, R203: 10k; R_0805_2012Metric_Pad1.20x1.40mm_HandSolder
R204, R205, R206: 1k; R_0805_2012Metric_Pad1.20x1.40mm_HandSolder
R207, R208, R209, R210: 5k1; R_0805_2012Metric_Pad1.20x1.40mm_HandSolder
R211, R212: 4k7; R_0805_2012Metric; LCSC C17673
SW201, SW202: SW_MEC_5E; SW_SPST_B3U-1000P; LCSC C720477
TP201: TestPoint; TestPoint_Pad_D1.0mm
U201: ESP32-S3-WROOM-1; LCSC C2913205
U202: CH343P; TQFN-16-1EP_3x3mm_P0.5mm_EP1.23x1.23mm; LCSC C2846043
U203: AMS1117-3.3; SOT-223-3_TabPin2; LCSC C347222

Connections:
+3V3: C201.1, C202.1, C206.1, C207.1, C210.1, C211.2, C212.2, J204.1, J204.3, J204.5, JP201.2 (B), JP208.1 (A), JP209.1 (A), R202.1, R203.1, R204.1, R205.1, R206.1, R211.1, R212.2, U202.1 (VIO), U202.3 (VDD5), U202.6 (V3), U203.2 (VO); also elsewhere on the board
+5V: C204.1, C205.1, J204.2, J204.4, J204.6, U203.3 (VI); also elsewhere on the board
+BATT: J203.1, J203.2; also elsewhere on the board
/5V_ESP32: D204.1 (K), D210.1 (K); also elsewhere on the board
/ESP32/AIN1.1: J203.6, U201.23 (GPIO21)
/ESP32/AIN1.2: J203.7, U201.24 (GPIO47/SPICLK_P/SUBSPICLK_P_DIFF)
/ESP32/AIN2.1: J203.5, U201.22 (GPIO14/TOUCH14/ADC2_CH3/FSPIWP/FSPIDQS/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)
/ESP32/AIN2.2: J203.4, U201.21 (GPIO13/TOUCH13/ADC2_CH2/FSPIQ/FSPIIO7/S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)
/ESP32/CHIP_PU: C203.1, C208.1, JP206.2 (B), R201.2, R202.2, SW201.1, SW201.3, U201.3 (EN)
/ESP32/COMM: J204.10, U201.12 (GPIO8/TOUCH8/ADC1_CH7/SUBSPICS1)
/ESP32/D+: D206.2 (A2), J201.A6 (D+), J201.B6 (D+), U202.7 (UD+)
/ESP32/D-: D207.2 (A2), J201.A7 (D-), J201.B7 (D-), U202.8 (UD-)
/ESP32/DTR: Q201.2 (B1), Q201.4 (E2), U202.12 (DTR)
/ESP32/E1_Signal1: J203.17, U201.38 (GPIO2/TOUCH2/ADC1_CH1)
/ESP32/E1_Signal2: J203.18, U201.39 (GPIO1/TOUCH1/ADC1_CH0)
/ESP32/E2_Signal1: J203.15, U201.34 (MTDI/GPIO41/CLK_OUT1)
/ESP32/E2_Signal2: J203.16, U201.35 (MTMS/GPIO42)
/ESP32/EIN1.1: J203.11, U201.30 (SPIDQS/GPIO37/FSPIQ/SUBSPIQ)
/ESP32/EIN1.2: J203.10, U201.29 (SPIIO7/GPIO36/FSPICLK/SUBSPICLK)
/ESP32/EIN2.1: J203.12, U201.31 (GPIO38/FSPIWP/SUBSPIWP)
/ESP32/EIN2.2: J203.13, U201.32 (MTCK/GPIO39/CLK_OUT3/SUBSPICS1)
/ESP32/ESP32_3V3: JP201.1 (A), R201.1, U201.2 (3V3)
/ESP32/GPIO0: JP207.2 (B), R203.2, SW202.1, SW202.3, U201.27 (GPIO0/BOOT)
/ESP32/GPIO4: J204.18, U201.4 (GPIO4/TOUCH4/ADC1_CH3)
/ESP32/GPIO5: J204.16, U201.5 (GPIO5/TOUCH5/ADC1_CH4)
/ESP32/GPIO6: J204.14, U201.6 (GPIO6/TOUCH6/ADC1_CH5)
/ESP32/GPIO7: J204.11, U201.7 (GPIO7/TOUCH7/ADC1_CH6)
/ESP32/GPIO9: J204.8, JP205.1 (A), JP205.2 (B), R212.1, U201.17 (GPIO9/TOUCH9/ADC1_CH8/FSPIHD/SUBSPIHD)
/ESP32/GPIO10: J204.7, JP204.1 (A), JP204.2 (B), R211.2, U201.18 (GPIO10/TOUCH10/ADC1_CH9/FSPICS0/FSPIIO4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)
/ESP32/GPIO11: TP201.1, U201.19 (GPIO11/TOUCH11/ADC2_CH0/FSPID/FSPIIO5/S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)
/ESP32/GPIO12: J203.3, U201.20 (GPIO12/TOUCH12/ADC2_CH1/FSPICLK/FSPIIO6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)
/ESP32/GPIO15: J204.12, U201.8 (GPIO15/U0RTS/ADC2_CH4/XTAL_32K_P)
/ESP32/GPIO16: J204.9, U201.9 (GPIO16/U0CTS/ADC2_CH5/XTAL_32K_N)
/ESP32/GPIO17: U201.10 (GPIO17/U1TXD/ADC2_CH6); also elsewhere on the board
/ESP32/GPIO18: U201.11 (GPIO18/U1RXD/ADC2_CH7/CLK_OUT3); also elsewhere on the board
/ESP32/GPIO19: D211.2 (A2), J202.A7 (D-), J202.B7 (D-), U201.13 (GPIO19/U1RTS/ADC2_CH8/CLK_OUT2/USB_D-)
/ESP32/GPIO20: D209.2 (A2), J202.A6 (D+), J202.B6 (D+), U201.14 (GPIO20/U1CTS/ADC2_CH9/CLK_OUT1/USB_D+)
/ESP32/GPIO35: J203.9, U201.28 (SPIIO6/GPIO35/FSPID/SUBSPID)
/ESP32/GPIO40: J203.14, U201.33 (MTDO/GPIO40/CLK_OUT2)
/ESP32/GPIO48: J203.8, U201.25 (GPIO48/SPICLK_N/SUBSPICLK_N_DIFF)
/ESP32/RTS: Q201.1 (E1), Q201.5 (B2), U202.13 (RTS)
/ESP32/U0RXD: D202.1 (K), JP203.1 (A), U201.36 (U0RXD/GPIO44/CLK_OUT2)
/ESP32/U0TXD: D203.1 (K), JP202.1 (A), U201.37 (U0TXD/GPIO43/CLK_OUT1)
GND: C201.2, C202.2, C203.2, C204.2, C205.2, C206.2, C207.2, C208.2, C209.2, C210.2, C211.1, C212.1, D201.1 (K), D205.1 (A1), D206.1 (A1), D207.1 (A1), D208.1 (A1), D209.1 (A1), D211.1 (A1), J201.A1 (GND), J201.A12 (GND), J201.B1 (GND), J201.B12 (GND), J201.S1 (SHIELD), J202.A1 (GND), J202.A12 (GND), J202.B1 (GND), J202.B12 (GND), J202.S1 (SHIELD), J203.19, J203.20, J204.13, J204.15, J204.17, J204.19, J204.20, R207.2, R208.2, R209.2, R210.2, SW201.2, SW201.4, SW202.2, SW202.4, U201.1 (GND), U201.40 (GND), U201.41 (GND), U202.2 (GND), U202.17 (GND), U203.1 (GND); also elsewhere on the board
unnamed: D201.2 (A), R204.2
unnamed: D202.2 (A), R205.2
unnamed: D203.2 (A), R206.2
unnamed: J201.A5 (CC1), R207.1
unnamed: J201.B5 (CC2), R208.1
unnamed: J202.A5 (CC1), R209.1
unnamed: J202.B5 (CC2), R210.1
unnamed: JP202.2 (B), U202.5 (RXD)
unnamed: JP203.2 (B), U202.4 (TXD)
unnamed: JP206.1 (A), Q201.6 (C1)
unnamed: JP207.1 (A), Q201.3 (C2)
VBUS: C209.1, D204.2 (A), D205.2 (A2), D208.2 (A2), D210.2 (A), J201.A4 (VBUS), J201.A9 (VBUS), J201.B4 (VBUS), J201.B9 (VBUS), J202.A4 (VBUS), J202.A9 (VBUS), J202.B4 (VBUS), J202.B9 (VBUS), U202.9 (VBUS)

Notes on the sheet:
USB to UART
UART1
Encoder 1
Line Sensor
I2C
Motor 2
PINOUT
MPU6050
USB C
ESP to USB
Motor 1
ESP32 S3 WROOM N8R8
Power Output
LED
Extra
Encoder 2
LDO

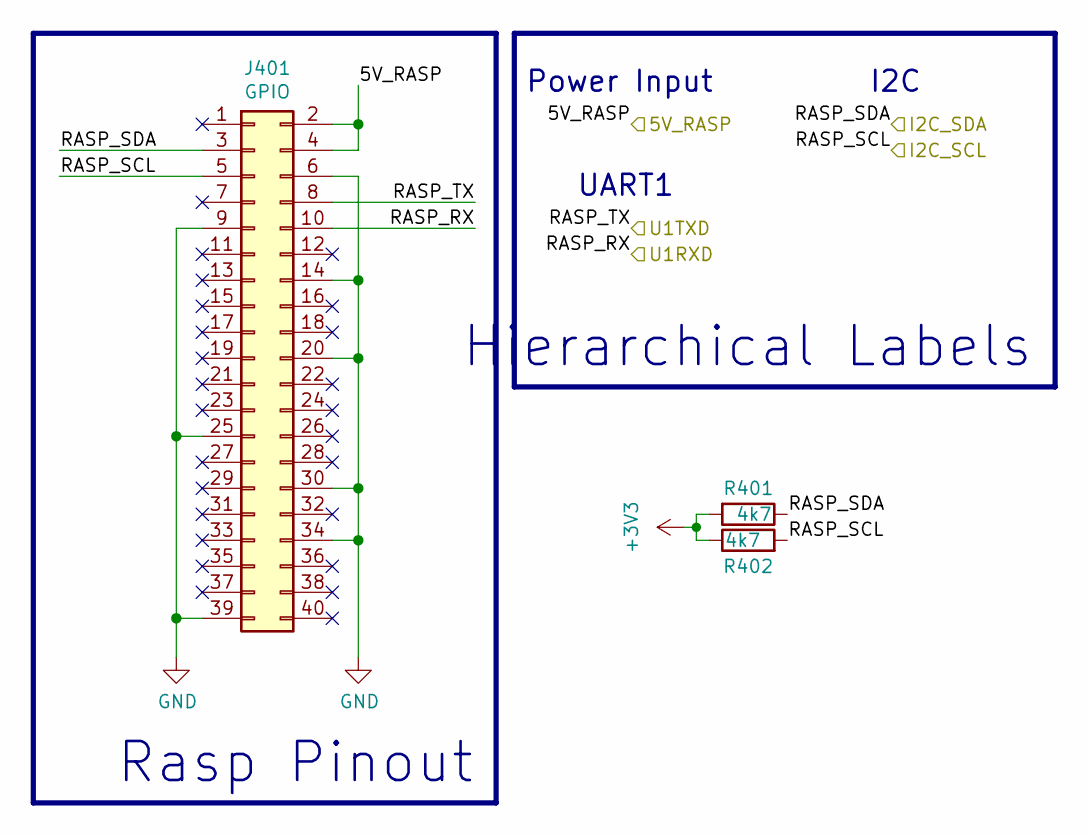
[picture p20: schematic Raspberry Pi.kicad_sch]

Parts:
J401: GPIO; PinSocket_2x20_P2.54mm_Vertical
R401, R402: 4k7; R_0805_2012Metric; LCSC C17673

Connections:
+3V3: R401.2, R402.1; also elsewhere on the board
/5V_RASP: J401.2, J401.4; also elsewhere on the board
/Raspberry Pi/RASP_RX: J401.10; also elsewhere on the board
/Raspberry Pi/RASP_SCL: J401.5, R402.2; also elsewhere on the board
/Raspberry Pi/RASP_SDA: J401.3, R401.1; also elsewhere on the board
/Raspberry Pi/RASP_TX: J401.8; also elsewhere on the board
GND: J401.6, J401.9, J401.14, J401.20, J401.25, J401.30, J401.34, J401.39; also elsewhere on the board

Notes on the sheet:
I2C
UART1
Rasp Pinout
Power Input
Hierarchical Labels
