peedrooh/seebum_sobrado_pcb/seebum_esp32s3/seebum_esp32s3.kicad_pcb

## KiCad design seebum_esp32s3/seebum_esp32s3.kicad_pcb (continued)

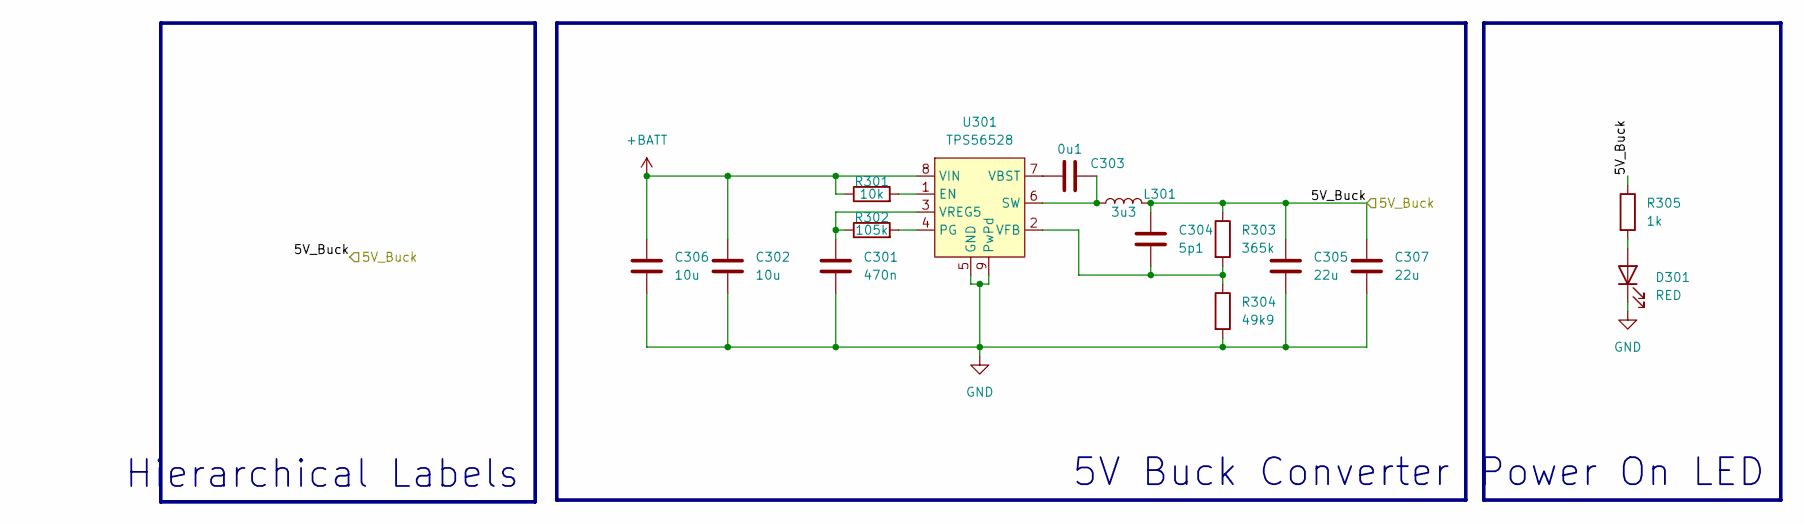
[picture p21: schematic Buck_Converter.kicad_sch]

Parts:
C301: 470n; C_0805_2012Metric_Pad1.18x1.45mm_HandSolder
C302: 10u; C_1210_3225Metric_Pad1.33x2.70mm_HandSolder
C303: 0u1; C_0805_2012Metric_Pad1.18x1.45mm_HandSolder
C304: 5p1; C_0805_2012Metric_Pad1.18x1.45mm_HandSolder
C305, C307: 22u; C_0805_2012Metric_Pad1.18x1.45mm_HandSolder
C306: 10u; C_1210_3225Metric_Pad1.33x2.70mm_HandSolder; LCSC C2918502
D301: RED; LED_0805_2012Metric
L301: 3u3; L_Bourns_SRP1050WA; LCSC C497894
R301: 10k; R_0805_2012Metric_Pad1.20x1.40mm_HandSolder
R302: 105k; R_0805_2012Metric_Pad1.20x1.40mm_HandSolder; LCSC C3000727
R303: 365k; R_0805_2012Metric_Pad1.20x1.40mm_HandSolder; LCSC C2999471
R304: 49k9; R_0805_2012Metric_Pad1.20x1.40mm_HandSolder; LCSC C17719
R305: 1k; R_0805_2012Metric_Pad1.20x1.40mm_HandSolder
U301: TPS56528; Texas_HSOP-8-1EP_3.9x4.9mm_P1.27mm_ThermalVias; LCSC C138716

Connections:
+BATT: C302.1, C306.1, R301.1, U301.8 (VIN); also elsewhere on the board
/5V_PSU: C304.1, C305.1, C307.1, L301.2, R303.1, R305.1; also elsewhere on the board
GND: C301.2, C302.2, C305.2, C306.2, C307.2, D301.1 (K), R304.2, U301.5 (GND), U301.9 (PwPd); also elsewhere on the board
unnamed: D301.2 (A), R305.2
unnamed: R301.2, U301.1 (EN)
unnamed: R302.2, U301.4 (PG)
unnamed: C303.2, L301.1, U301.6 (SW)
unnamed: C303.1, U301.7 (VBST)
unnamed: C304.2, R303.2, R304.1, U301.2 (VFB)
unnamed: C301.1, R302.1, U301.3 (VREG5)

Notes on the sheet:
Power On LED
5V Buck Converter
Hierarchical Labels

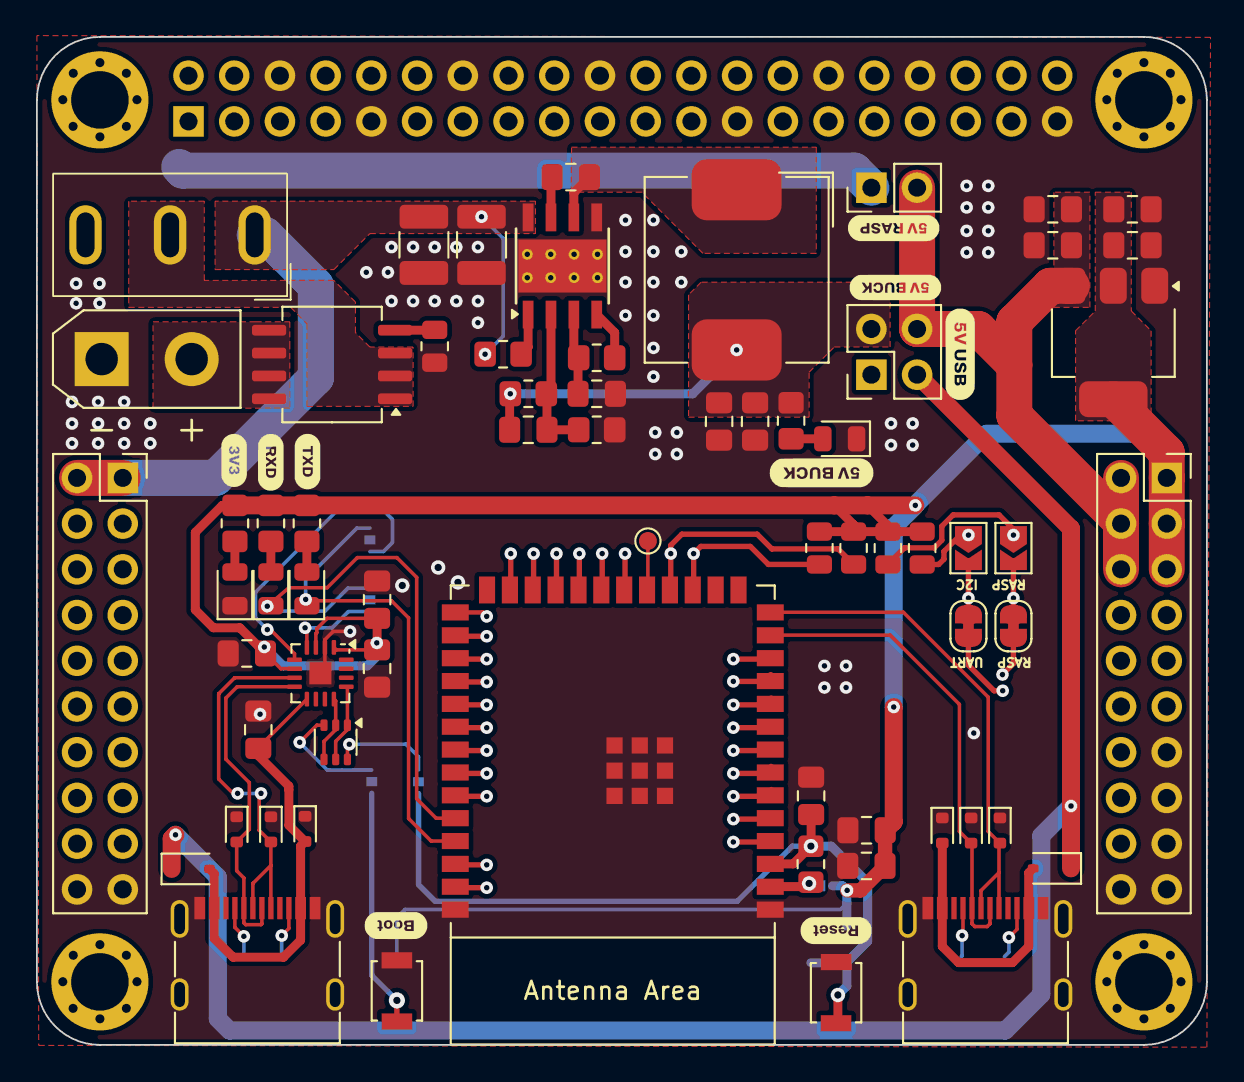
[picture p22: board seebum_esp32s3.kicad_pcb from above]

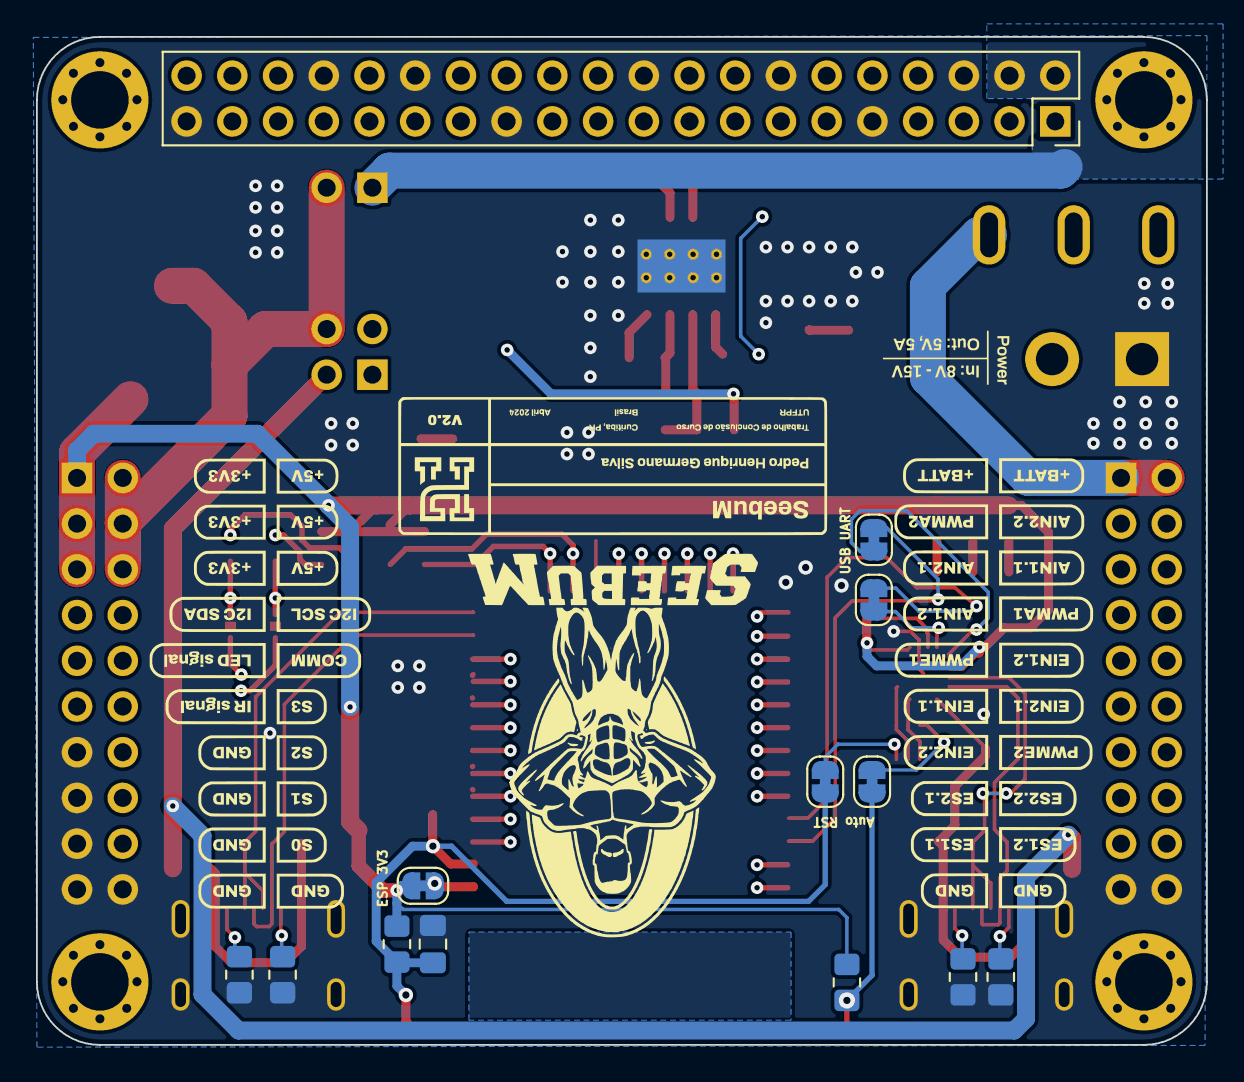
[picture p23: board seebum_esp32s3.kicad_pcb from below]

Board: 4 copper layers, 65.0 x 56.0 mm, 83 parts (15 on the bottom side), 72 nets.
