peedrooh/seebum_sobrado_pcb/chihai_12V/chihai_12V.kicad_pcb

## KiCad design chihai_12V/chihai_12V.kicad_pcb (2024-04-23)

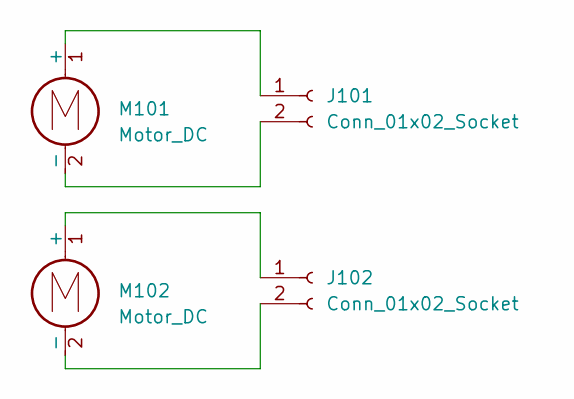
[picture p24: schematic chihai_12V.kicad_sch]

Parts:
J101, J102: Conn_01x02_Socket; JST_PH_S2B-PH-SM4-TB_1x02-1MP_P2.00mm_Horizontal
M101, M102: Motor_DC; Chihai_CHR_GM16

Connections:
unnamed: J101.1, M101.1 (+)
unnamed: J101.2, M101.2 (-)
unnamed: J102.1, M102.1 (+)
unnamed: J102.2, M102.2 (-)

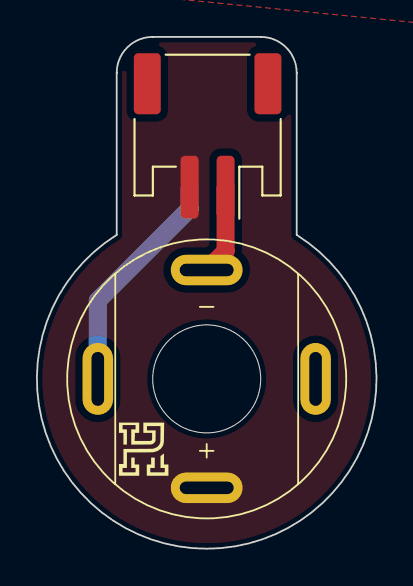
[picture p25: board chihai_12V.kicad_pcb from above]

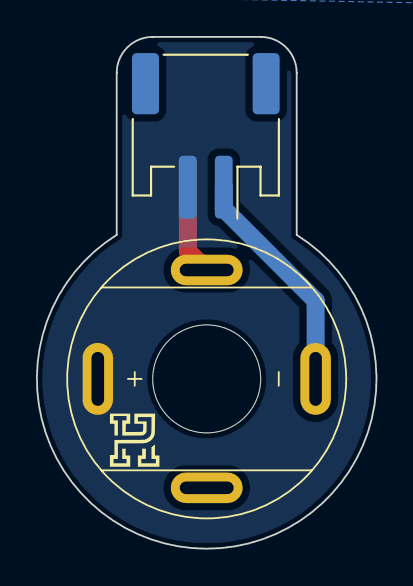
[picture p26: board chihai_12V.kicad_pcb from below]

Board: 2 copper layers, 18.9 x 28.4 mm, 4 parts (2 on the bottom side), 4 nets.
