peedrooh/seebum_sobrado_pcb/(commit log)

2024-04-23 Feat: add double chihai PCB
2024-04-23 Feat: some improvments
    [line_sensor.SLDASM, line_sensor.kicad_pcb, line_sensor.step, seebum_esp32s3.kicad_pcb, seebum_peripherals.SLDASM, seebum_peripherals.kicad_pcb, seebum_peripherals.step]
2024-04-23 last try
    [bom.csv, chihai_12V.kicad_pcb, chihai_12V.kicad_sch, designators.csv, positions.csv]
2024-04-26 Feat: fix uart1 schematic issue and I2C redundancy
    [ESP32.kicad_sch, Raspberry Pi.kicad_sch, seebum_esp32s3.kicad_pcb, seebum_esp32s3.kicad_sch]
2024-04-26 Feat: fix I2C and silkscreen
    [seebum_peripherals.kicad_pcb, seebum_peripherals.kicad_sch]
2024-04-26 Feat: fabrication files using JLCPCB plugin
    [bom.csv, designators.csv, line_sensor.kicad_pcb, positions.csv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]
2024-04-28 Feat: I2C and UART to same pins in ESP32, since any GPIO can be RxD and TxD
    [ESP32.kicad_sch, Raspberry Pi.kicad_sch, seebum_esp32s3.kicad_pcb, seebum_esp32s3.kicad_sch]
2024-05-30 Feat: final revision
    [Buck_Converter.kicad_sch, ESP32.kicad_sch, Raspberry Pi.kicad_sch, line_sensor.kicad_pcb, seebum_esp32s3.kicad_pcb, seebum_esp32s3.kicad_sch, seebum_peripherals.kicad_pcb]
